TanskiSzymon/open-pocket/hardware/mechanical/drawings/lid-drawing.pdf

70.4

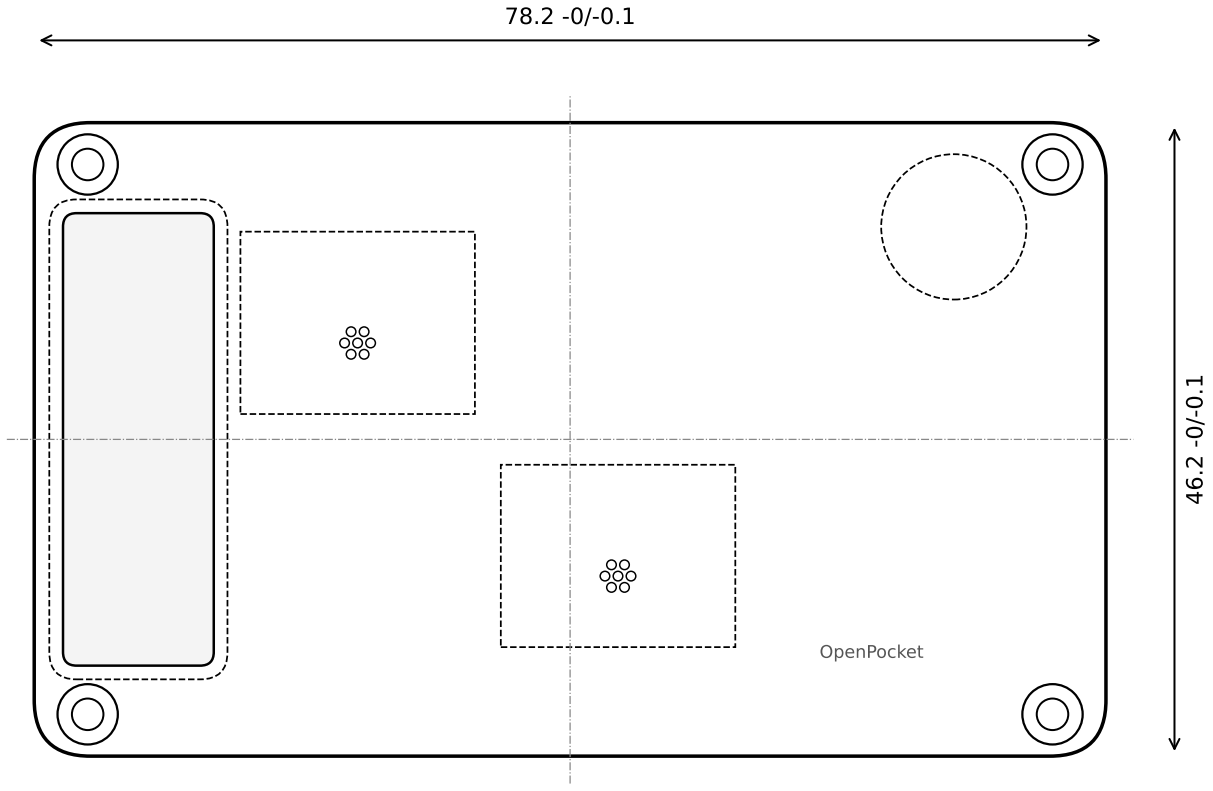
[picture p11: figure]
OpenPocket

40.1

RF window 11.0 x 33.0 R1.0 THRU at (-31.5, 0.0); underside recess 13.0 x 35.0 R2.0 ↓1.0

Mic recess 1 (underside) 17.1 x 13.3 ↓0.5 at (-15.5, 8.5); 7x Ø0.7 THRU grille (centre + hexagon, pitch 0.95) at (-15.51, 7.03)

Mic recess 2 (underside) same, at (3.5, -8.5); grille at (3.49, -9.97)

No LED hole: the status LED sits under the RF window insert, which is translucent

Motor recess (underside) Ø10.6 ↓0.5 at (28.0, 15.5)

4x Ø2.3 THRU, 90° countersink Ø4.4 on the top face, mouth R0.3, at (±35.2, ±20.1)

TOP VIEW (outside face), scale 1:1 at A3. Underside features shown dashed.

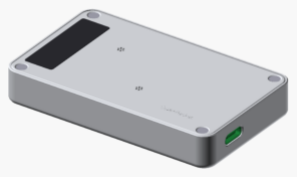
[picture p12: figure]

2.0

Plate 2.0 ±0.05, flatness 0.1. Recesses from the underside: RF flange ↓1.0, mics ↓0.5, motor ↓0.5 (all ±0.05). Top outer edge R0.5 round.

### SECTION B-B (along X through the RF window and a mic recess), scale 2:1

Isometric reference (not to scale)

# OpenPocket v0 — LID

Part no. OP0-MECH-011 | Rev B | Sheet 1/1 | RFQ ref. OP0-RFQ-001

MATERIAL: Aluminium 6061-T6 plate.

OVERALL: 78.2 x 46.2 x 2.0 mm, corners R4.1. Outline -0/-0.1:

the lid drops into the shell rebate (78.4 x 46.4) with 0.1 per side.

THICKNESS: 2.0 ±0.05, flatness 0.1 (the lid sits flush with the shell top).

SCREW HOLES: 4x Ø2.3 THRU with 90° countersink Ø4.4 on the top face,

mouth rounded R0.3 (no sharp ring). M2 flat heads seat 0.3 below the face.

Position ±0.05 (match the shell bosses).

RF WINDOW: 11.0 x 33.0 THRU, corners R1.0; underside recess

13.0 x 35.0 R2.0 ↓1.0 for the window insert flange.

UNDERSIDE RECESSES: 2x mic 17.1 x 13.3 ↓0.5;

motor Ø10.6 ↓0.5. Corner R0.5 max. Depth ±0.05.

MIC GRILLES: 2x 7 holes Ø0.7 THRU (acoustic), pitch 0.95.

Deburr both sides, no chamfer.

MARKING: laser mark on the top face (STEP, ↓0.05), after anodizing.

EDGES: R0.5 round on the top outer edge, R0.3 on the countersink mouths;

break the rest 0.2 max.

SURFACE: Ra 1.6 µm or better on the top face (visible product).

FINISH: same as the shell, same batch: (a) bead blast + black anodize Type II;

(b) bead blast + clear anodize; (c) as machined. Quote each.

QUANTITY FOR QUOTE: 1 / 10 / 100 / 1000 pcs, together with OP0-MECH-003 (shell).

FILES: openpocket-lid.step (master) + this PDF. STEP governs if in conflict.

ALL DIMENSIONS IN MILLIMETRES. Third-angle projection.

OpenPocket, open-source hardware (CERN-OHL-P v2). Contact on the cover sheet. Date: 2026-10-19. STEP file governs; this sheet carries tolerances, threads and finish.
