TanskiSzymon/open-pocket/hardware/mechanical/drawings/shell-drawing.pdf

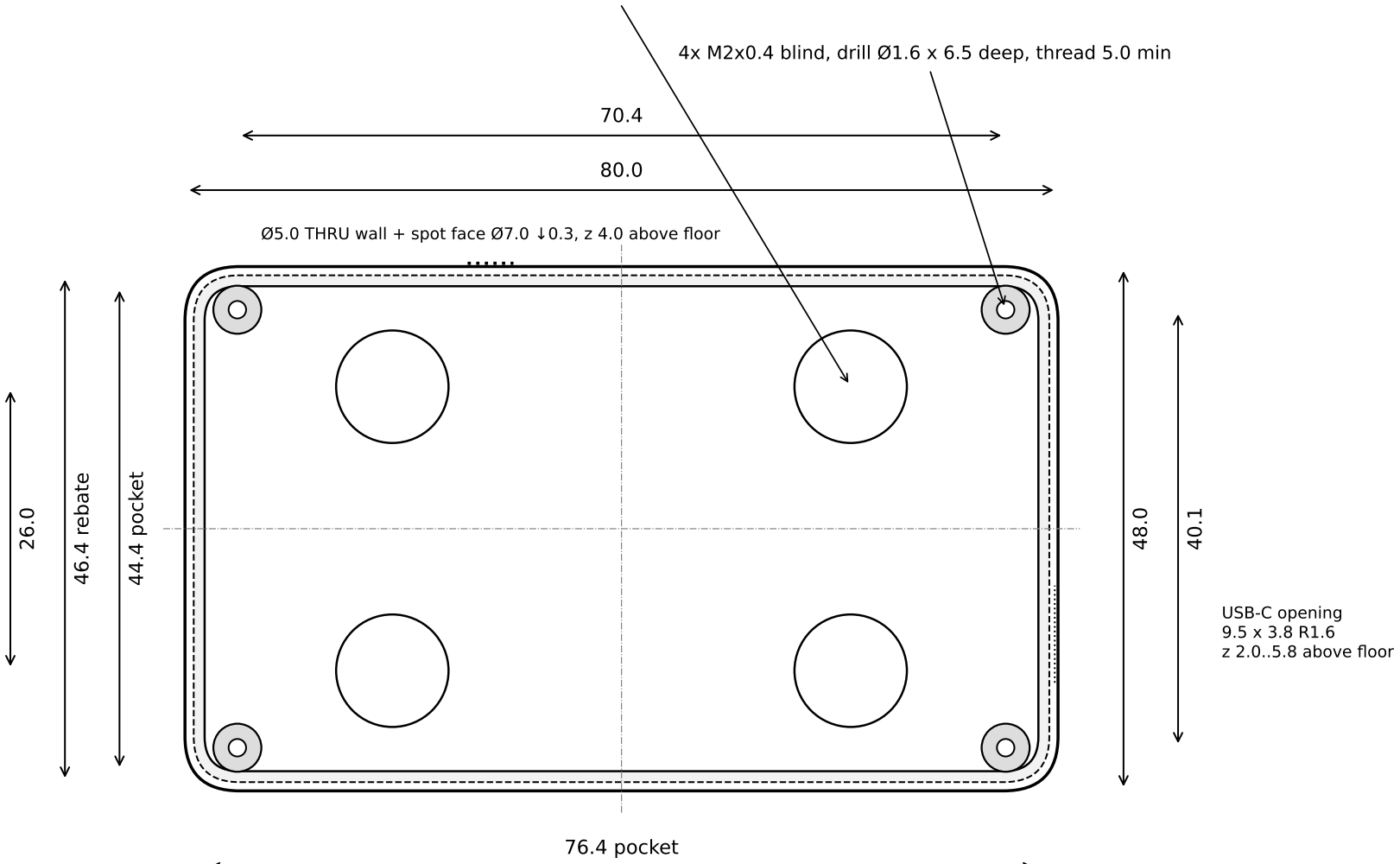
[picture p13: figure]
USB-C opening 9.5 x 3.8 R1.6 z 2.0..5.8 above floor; 76.4 pocket; 46.4 rebate; 44.4 pocket

Ø5.0 THRU wall + spot face Ø7.0 ↓0.3, z 4.0 above floor

78.4 rebate

42.0

4x M2x0.4 blind, drill Ø1.6 x 6.5 deep, thread 5.0 min

4x Ø10.3 +0.1/-0 POCKET ↓2.1 in the floor

R5 x4 outside, R3.2 x4 pocket (Ø6 end mill), R4.2 rebate

### TOP VIEW (open side), scale 1:1 at A3

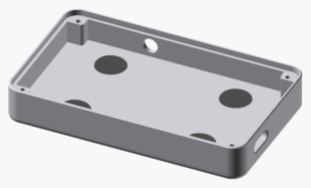
[picture p14: figure]

80.0

12.6

7.6 pocket depth

2.0 rebate

3.0

floor

Walls 1.8 (rebate leaves 0.8 outside the lid). Pocket floor to rebate 7.6 ±0.05.
Magnet pockets ↓2.1 leave 0.9 floor. R2.0 round on the bottom outer edge, C0.3 bright-cut chamfer on the top outer edge.

### SECTION A-A (along X through a boss row and the magnet pockets), scale 2:1

Isometric reference (not to scale)

# OpenPocket v0 — SHELL (floor + walls)

Part no. OP0-MECH-003 | Rev B | Sheet 1/1 | RFQ ref. OP0-RFQ-001

MATERIAL: Aluminium 6061-T6, from solid.

OVERALL: 80.0 x 48.0 x 12.6 mm, outer corners R5.

POCKET: 76.4 x 44.4 ±0.05, depth 7.6 ±0.05 from the rebate floor,

corner R3.2; 4 corner bosses Ø4.4 blended into the walls, flat inner face at |Y| = 18.5.

REBATE: 78.4 x 46.4 +0.05/-0, depth 2.0 +0/-0.05 from the top face,

corner R4.2. The lid (OP0-MECH-011) sits flush in it.

THREADS: 4x M2x0.4 blind in the bosses, drill Ø1.6 x 6.5, thread 5.0 min,

from the top. Do NOT break through the floor. Mask for anodize or chase after.

MAGNET POCKETS: 4x Ø10.3 +0.1/-0, depth 2.1 ±0.05 from the pocket floor,

flat bottom, floor left 0.9. Position ±0.05.

OPENINGS: USB-C 9.5 x 3.8 R1.6 ends, C0.3 x 45° outside, through the +X wall;

Ø5.0 through the +Y wall with a spot face Ø7.0 ↓0.3. Positions per STEP, ±0.1.

TOLERANCES (unless noted): ±0.1 linear; bottom flatness 0.1; walls 1.8 ±0.1.

EDGES: R2.0 round bottom outer edge; C0.3 x 45° top outer edge, cut after

anodizing (bright edge) if you offer it, else before. Break the rest 0.2 max.

MARKING: laser mark on the bottom face (text in STEP, ↓0.05), after anodizing.

SURFACE: Ra 1.6 µm or better on all outside faces (visible product).

FINISH: (a) bead blast + black anodize Type II; (b) bead blast + clear

anodize; (c) as machined. Quote each. Mask the threads.

QUANTITY FOR QUOTE: 1 / 10 / 100 / 1000 pcs, together with OP0-MECH-011 (lid).

1 pc now for testing, ~1000 target. State lead time, capacity, shipping PL / USA.

FILES: openpocket-shell.step (master) + this PDF. STEP governs if in conflict.

ALL DIMENSIONS IN MILLIMETRES. Third-angle projection.

OpenPocket, open-source hardware (CERN-OHL-P v2). Contact on the cover sheet. Date: 2026-10-19. STEP file governs; this sheet carries tolerances, threads and finish.
