TanskiSzymon/open-pocket/hardware/mechanical/renders/render-exploded.png

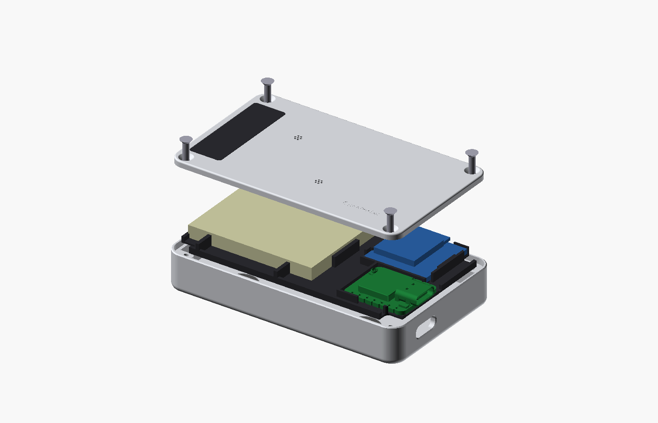
hardware/mechanical/renders/render-exploded.png
