TanskiSzymon/open-pocket/hardware/mechanical/renders/render-lid-under.png

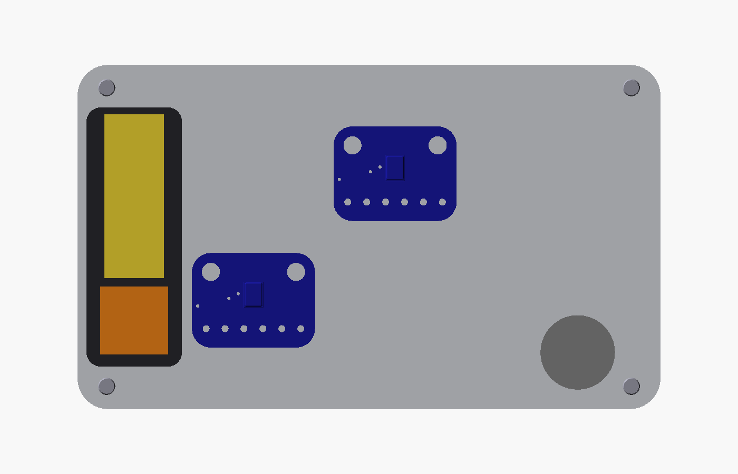
hardware/mechanical/renders/render-lid-under.png
