TanskiSzymon/open-pocket/hardware/mechanical/renders/render-shell.png

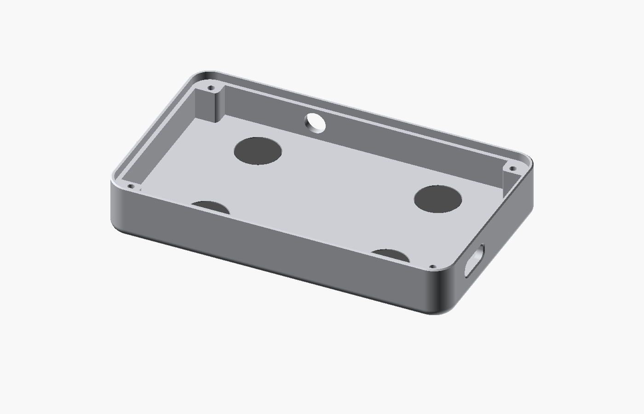
hardware/mechanical/renders/render-shell.png
