TanskiSzymon/open-pocket/hardware/mechanical/renders/render-top.png

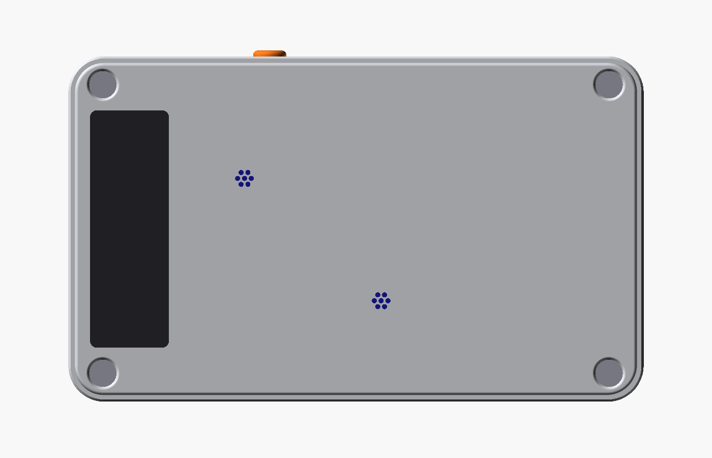
hardware/mechanical/renders/render-top.png
