TanskiSzymon/open-pocket/hardware/mechanical/renders/render-tray.png

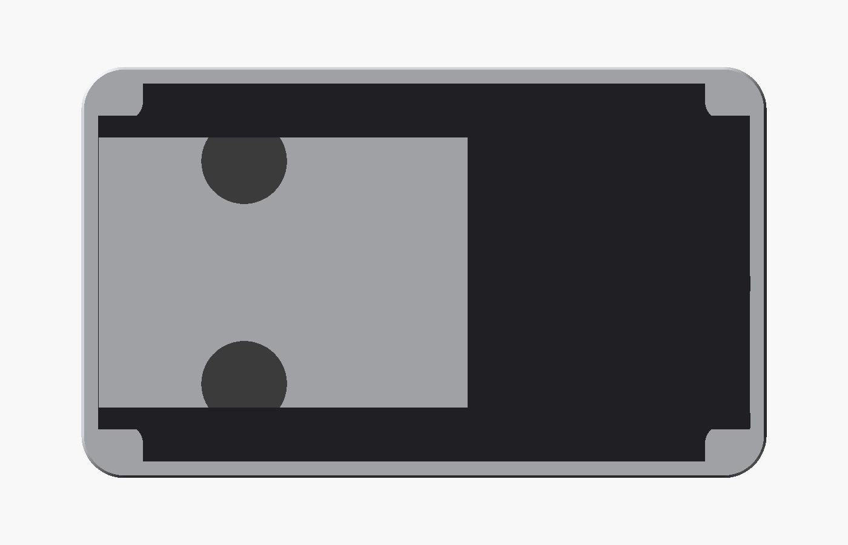
hardware/mechanical/renders/render-tray.png
