TanskiSzymon/open-pocket/hardware/mechanical/renders/render-usb-end.png

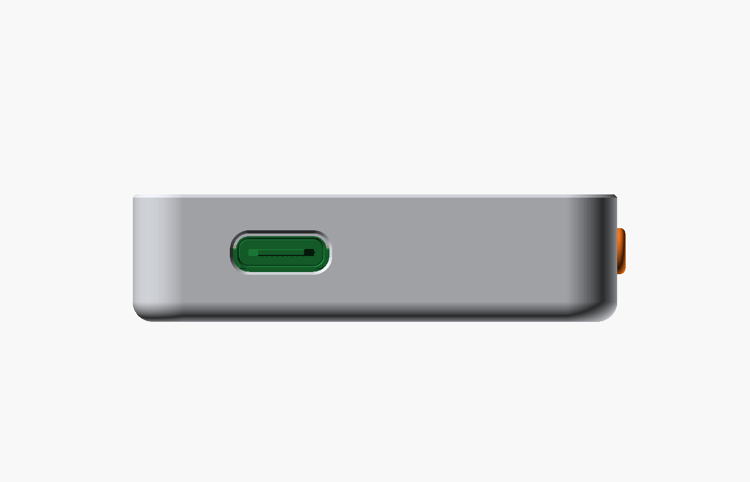
hardware/mechanical/renders/render-usb-end.png
