TanskiSzymon/open-pocket/images/openpocket-collage.jpg

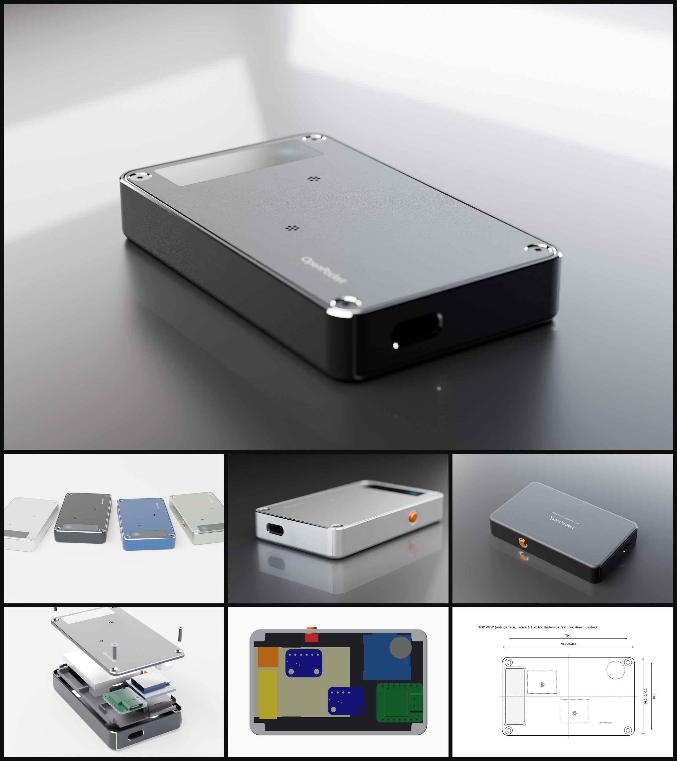
images/openpocket-collage.jpg
