TanskiSzymon/open-pocket/bom/bom.csv

id | category | qty | description | mpn_or_part | manufacturer | preferred_supplier | supplier_sku_or_link | alt_supplier | unit_price_usd_est | required | file | notes
OP0-ELEC-001 | electronics | 1 | Seeed Studio XIAO ESP32S3 (plain, no Sense expansion board; MCU + Wi-Fi/BLE + LiPo charger, FPC antenna included) | 113991114 | Seeed Studio | Digi-Key | 1597-113991114-ND ($7.49, 10113 in stock 13.10.2026) | Seeed Studio https://www.seeedstudio.com/XIAO-ESP32S3-p-5627.html ($7.49) | 7.49 | yes |  | The Sense expansion board (camera + microSD) stacks to 8.5 mm; the plain board is 4.5 mm and sets the slim enclosure. microSD comes from OP0-ELEC-014.
OP0-ELEC-002 | electronics | 2 | I2S MEMS microphone breakout SPH0645LM4H (bottom port) | 3421 | Adafruit | Digi-Key | 1528-1908-ND ($6.95, 2163 in stock 13.10.2026) | Adafruit https://www.adafruit.com/product/3421 (in stock) | 6.95 | yes |  | ICS-43434 (6049) is discontinued; 3421 is the drop-in. Verify port position against the 7-hole Ø0.7 lid grille.
OP0-ELEC-003 | electronics | 1 | LiPo battery 403040, 3.7 V 450-500 mAh, 4 mm thick, with protection circuit (PCM) and leads | 403040 | generic (Liter / HXJNLDC / AKZYTUE) | Amazon | https://www.amazon.com/dp/B0CHBGZ778 (403040 500 mAh, PCM) | https://www.amazon.com/dp/B09FLYNRPG (Liter 403040 500 mAh, JST) | 7.00 | yes |  | Envelope used in CAD: 42.5 x 31 x 4.2 mm incl. PCM lead end; measure before fitting. ~10 h recording at 32 kbps MP3. Connector is cut off, leads solder to the XIAO BAT pads.
OP0-ELEC-004 | electronics | 1 | Tactile switch 6x6 mm, through-hole, 5.0 mm total height, round plunger, 100 gf | B3F-1022 | Omron (Aratas) | Digi-Key | search "B3F-1022" (verify stock before ordering) | any 6x6 THT tact switch with 5.0 mm total height and Ø3.5 round plunger | 0.40 | yes |  | Since 19.10.2026 the 5.0 mm version: the body sits 0.8 mm behind the wall and the plunger drives the captive aluminium button cap (OP0-MECH-012).
OP0-ELEC-005 | electronics | 1 | NeoPixel Mini Button PCB (WS2812B/SK6812, 9.1 x 9.1 x 3.2 mm) — pack of 5 | 1612 | Adafruit | Mouser | 485-1612 ($4.95, 15 in stock 19.10.2026) | Adafruit https://www.adafruit.com/product/1612 ($4.95) | 4.95 | yes |  | Only one used. Sits in a 0.4 mm recess on the underside of the translucent RF window insert at (-31.5, 11.2); no hole in the metal lid. Digi-Key 1528-1104-ND is Adafruit 1655 (bare 5050 LEDs), not this part. Rated 5 V (3.5 V min): at 3.3 V colours are dimmer; check on unit 1. Flora NeoPixel 1260 was the first choice but is out of stock at Adafruit (13.10.2026).
OP0-ELEC-006 | electronics | 1 | Vibration motor, coin 10 mm x 2.7 mm, 3 V | 1201 | Adafruit | Adafruit | https://www.adafruit.com/product/1201 | Digi-Key 1528-1177-ND | 1.95 | optional |  | Haptic feedback like the original Pocket. Needs driver below.
OP0-ELEC-007 | electronics | 1 | NPN transistor 2N2222 TO-92 | PN2222A | onsemi | Digi-Key | search "PN2222A" (onsemi PN2222ABU) or P2N2222A | Adafruit 756 (PN2222, pack of 10) | 0.20 | optional |  | Motor driver.
OP0-ELEC-008 | electronics | 1 | Diode 1N4148 (flyback across motor) | 1N4148 | onsemi | Digi-Key | 1N4148FS-ND ($0.10, in stock) |  | 0.10 | optional
OP0-ELEC-009 | electronics | 1 | Resistor 470 Ω 1/4 W (motor base) | CF14JT470R | Stackpole | Digi-Key | CF14JT470RCT-ND ($0.10) |  | 0.10 | optional |  | Was 1 kΩ until 19.10.2026: 470 Ω gives ~5.5 mA base current for hard saturation at the motor start current.
OP0-ELEC-010 | electronics | 2 | Resistor 220 kΩ 1/4 W (VBAT divider) | CF14JT220K | Stackpole | Digi-Key | CF14JT220KCT-ND ($0.10) |  | 0.10 | optional |  | Battery voltage sense on D0.
OP0-ELEC-011 | electronics | 3 | Capacitor 100 nF ceramic X7R (microSD breakout VCC/GND, VBAT divider D0 to GND, across motor) | K104K15X7RF5TL2 | Vishay | Digi-Key | BC1084CT-ND ($0.31) |  | 0.31 | yes |  | 2 required: at the microSD breakout (VCC to GND) and D0 to GND on the VBAT divider. The third, across the motor terminals, is optional with the motor.
OP0-ELEC-012 | electronics | 1 | microSD card 32 GB, class 10 / A1 |  | SanDisk | Amazon | https://www.amazon.com/s?k=SanDisk+Ultra+32GB+microSDHC+A1 |  | 8.00 | yes |  | Recordings are stored here.
OP0-ELEC-013 | electronics | 1 | Silicone hook-up wire 30 AWG, 6 colours (spool kit) |  |  | Amazon | https://www.amazon.com/dp/B07G2SWB19 (TUOFENG 30 AWG, 6 colours, 20 m each) | Adafruit 2051 (wire bundle) | 9.00 | yes |  | About 60 cm used per device.
OP0-ELEC-014 | electronics | 1 | microSD breakout, SparkFun microSD Transflash Breakout (Molex push-push socket, 21.6 x 20.3 x 3.5 mm) | BOB-00544 | SparkFun | SparkFun | https://www.sparkfun.com/sparkfun-microsd-transflash-breakout.html ($5.95, in stock 13.10.2026) | Digi-Key 1568-1345-ND (search "BOB-00544") | 5.95 | yes |  | Wired over SPI: CS D5, SCK D8, DO D9, DI D10, 3V, GND. Card edge toward the +Y wall slot; snap lips on the tub hold the PCB. Do not solder the header.
OP0-ELEC-015 | electronics | 4 | Resistor 10 kΩ 1/4 W (microSD pull-ups) | CF14JT10K0 | Stackpole | Digi-Key | CF14JT10K0CT-ND ($0.10) |  | 0.10 | yes |  | Pull-ups to 3V3 at the breakout pads on CS, DO (MISO), DAT1 (socket pin 8) and DAT2 (socket pin 1). Holds the card deselected while the ESP32 boots.
OP0-ELEC-016 | electronics | 1 | Resistor 10 kΩ 1/4 W (motor base-emitter pull-down) | CF14JT10K0 | Stackpole | Digi-Key | CF14JT10K0CT-ND ($0.10) |  | 0.10 | optional |  | Keeps Q1 off while GPIO44 floats during boot. Same part as OP0-ELEC-015 (order 5).
OP0-ELEC-017 | electronics | 1 | Resistor 100 kΩ 1/4 W (I2S DOUT pull-down) | CF14JT100K | Stackpole | Digi-Key | CF14JT100KCT-ND ($0.10) |  | 0.10 | yes |  | DOUT to GND at the XIAO pin (D3): discharges the shared data line while both mics are high-Z (SPH0645 datasheet).
OP0-ELEC-018 | electronics | 1 | Resistor 33 Ω 1/4 W (I2S BCLK series) | CF14JT33R0 | Stackpole | Digi-Key | CF14JT33R0CT-ND ($0.10) |  | 0.10 | yes |  | In series with BCLK right at the XIAO pin (D1): one wire drives two mics.
OP0-ELEC-019 | electronics | 1 | Capacitor 10 µF 16 V X5R 0805 (microSD breakout) | GRM21BR61C106KE15L | Murata | JLCPCB / LCSC | C77075 ($0.04) | Digi-Key 490-3886-1-ND (out of stock 19.10.2026) | 0.04 | yes |  | Across VCC/GND at the breakout pads, beside the 100 nF (card write bursts). 0805 solders across two adjacent pads or wire ends.
OP0-ELEC-020 | electronics | 1 | Capacitor 10 µF 16 V X5R 0805 (motor bulk) | GRM21BR61C106KE15L | Murata | JLCPCB / LCSC | C77075 ($0.04) | Digi-Key 490-3886-1-ND (out of stock 19.10.2026) | 0.04 | optional |  | Motor+ (BAT+) to GND at the motor. Same part as OP0-ELEC-019 (order 2).
OP0-MECH-001 | 3d-print | 1 | Tray (printed): floor plate with the XIAO and microSD cradles, snap lips, battery cutout and ribs, switch cradle; drops into the shell pocket | OP0-MECH-001 | OpenPocket | self-print / MakerWorld | hardware/mechanical/export/openpocket-tray.stl | JLC3DP / Craftcloud | 1.00 | yes | hardware/mechanical/export/openpocket-tray.stl | PETG or PLA, 0.2 mm layers, print flat (floor on the bed), no supports. Check the 0.5 / 0.3 mm snap lips on the first print.
OP0-MECH-002 | 3d-print | 1 | RF window insert (printed, translucent smoke or natural PETG; or laser-cut smoked acrylic): 10.8 x 32.8 x 2.0 plug (R0.9 corners) with a 1 mm flange, glued flush into the lid cutout; antenna and NeoPixel under it | OP0-MECH-002 | OpenPocket | self-print / MakerWorld | hardware/mechanical/export/openpocket-rf-insert.stl | JLC3DP / Craftcloud | 0.20 | yes | hardware/mechanical/export/openpocket-rf-insert.stl | Print flange down, 0.1 mm layers, 100% infill so it stays translucent. Alternative: laser-cut 2 mm smoked acrylic plug + 1 mm flange glued. The FPC antenna sticks to its underside; the NeoPixel sits in a 0.4 mm recess at the +Y end and lights the whole window.
OP0-MECH-003 | cnc-aluminium | 1 | Shell, aluminium 6061-T6 from solid, 80 x 48 x 12.6 mm: floor 3 mm with 4 magnet pockets, 1.8 mm walls, pocket 76.4 x 44.4 x 7.6, lid rebate, 4 corner bosses tapped M2 blind, USB-C opening 9.5 x 3.8 and button hole; bead blast + anodize | OP0-MECH-003 | OpenPocket | CNC shop (STEP + drawing) | hardware/mechanical/drawings/ | Xometry / Protolabs / Fictiv | 150.00 | yes | openpocket-backplate.step | Price is the thing we are measuring. Drawing: hardware/mechanical/drawings/shell-drawing.pdf
OP0-MECH-011 | cnc-aluminium | 1 | Lid, aluminium 6061-T6 plate, 78.2 x 46.2 x 2.0 mm: 4 countersunk M2 holes, 2 seven-hole mic grilles (Ø0.7), 11 x 33 R1 RF window cutout, laser mark, underside recesses for mics / motor / window flange; bead blast + anodize | OP0-MECH-011 | OpenPocket | CNC shop (STEP + drawing) | hardware/mechanical/drawings/ | same shop as the shell, same anodize batch | 60.00 | yes | hardware/mechanical/export/openpocket-lid.step | Two-sided machining (top: countersinks, window; bottom: recesses). Drawing: hardware/mechanical/drawings/lid-drawing.pdf
OP0-MECH-012 | cnc-aluminium | 1 | Button cap, turned aluminium 6061, Ø4.6 shaft with Ø6.2 x 0.35 flange (captive inside the wall), domed face 0.8 mm proud; orange anodize | OP0-MECH-012 | OpenPocket | CNC / lathe shop | hardware/mechanical/export/openpocket-button-cap.step | print in PETG until machined | 3.00 | yes | hardware/mechanical/export/openpocket-button-cap.step | Fits over the B3F-1022 plunger (bore Ø3.6). Insert from inside before the switch.
OP0-MECH-004 | hardware | 4 | Neodymium disc magnet N52, 10 mm x 2 mm |  |  | Amazon | https://www.amazon.com/dp/B0C5V31YCR (10x2 mm, 20 pcs; check grade) or search "AplysiaTech 10x2mm N52" | K&J Magnetics D62 (3/8 x 1/8 in = 9.5 x 3.2 mm, needs pocket depth 3.4) | 0.25 | yes |  | Glued into plate pockets with CA or epoxy. Check polarity against a MagSafe phone before gluing.
OP0-MECH-005 | hardware | 4 | Screw M2 x 8 mm flat head countersunk (90 deg), Phillips or Torx, stainless 18-8 (A2) |  |  | Amazon | https://www.amazon.com/s?k=M2+x+8mm+flat+head+countersunk+screws+stainless (100 pcs) | McMaster-Carr: metric 18-8 flat head Phillips, M2 x 0.4, 8 mm | 0.15 | yes |  | Through the lid countersinks into the blind M2 threads in the shell bosses (5 mm engagement). Tighten lightly; aluminium threads.
OP0-MECH-006 | consumable | 1 | Double-sided tape 0.2 mm (3M 9448A or similar), 10 mm wide | 9448A | 3M | Amazon | https://www.amazon.com/s?k=3M+9448A+double+sided+tape+10mm |  | 5.00 | yes |  | Mics (ring around the port = acoustic seal), LED, motor, antenna to lid.
OP0-MECH-007 | consumable | 1 | Foam tape 0.5 mm double-sided (battery pad) |  |  | Amazon | https://www.amazon.com/s?k=0.5mm+double+sided+foam+tape |  | 4.00 | yes |  | Under the battery on the aluminium plate.
OP0-MECH-008 | consumable | 1 | Kapton tape 10 mm |  |  | Amazon | https://www.amazon.com/s?k=kapton+tape+10mm |  | 5.00 | yes |  | Over XIAO battery pads and switch legs.
OP0-MECH-009 | consumable | 1 | Heat-shrink tubing 1.5 mm and 3 mm |  |  | Amazon | https://www.amazon.com/s?k=heat+shrink+tubing+kit+1.5mm+3mm |  | 6.00 | yes
OP0-MECH-010 | consumable | 1 | CA glue (magnets) |  |  | Amazon | https://www.amazon.com/s?k=Loctite+401 |  | 4.00 | yes
