TanskiSzymon/open-pocket/hardware/mechanical/export/openpocket-lid-outline.dxf

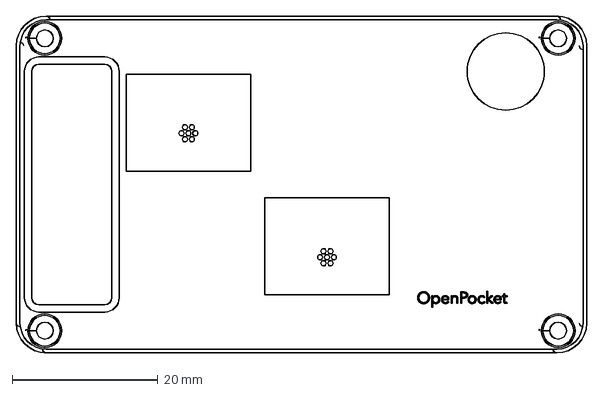
[picture p22: CAD file, 2026-10-19]
hardware/mechanical/export/openpocket-lid-outline.dxf
78.2 x 46.2 mm
