TanskiSzymon/open-pocket/hardware/mechanical/export/openpocket-shell-outline.dxf

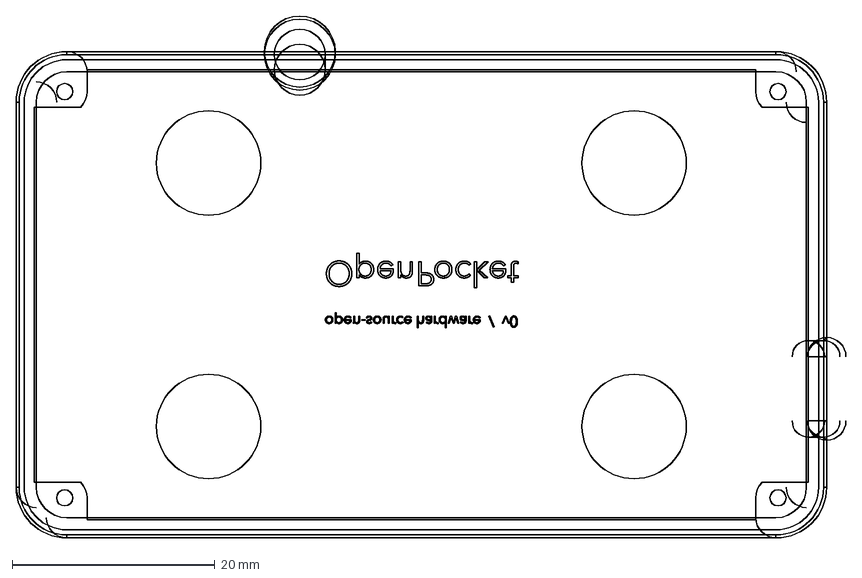
[picture p23: CAD file, 2026-10-19]
hardware/mechanical/export/openpocket-shell-outline.dxf
81.9 x 51.5 mm
