TanskiSzymon/open-pocket/hardware/mechanical/export/comp-mic2.stl

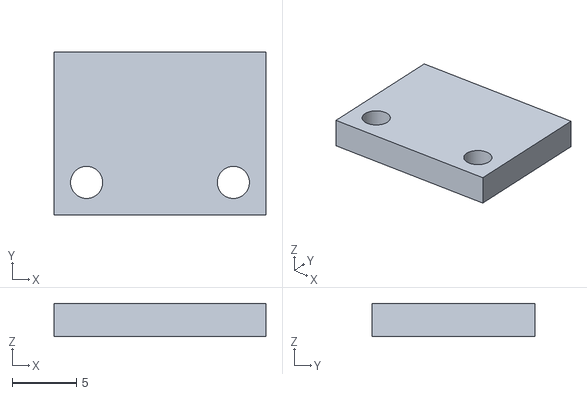
[picture p24: CAD file, 2026-10-19]
hardware/mechanical/export/comp-mic2.stl
16.5 x 12.7 x 2.60
