TanskiSzymon/open-pocket/hardware/mechanical/export/comp-sd.stl

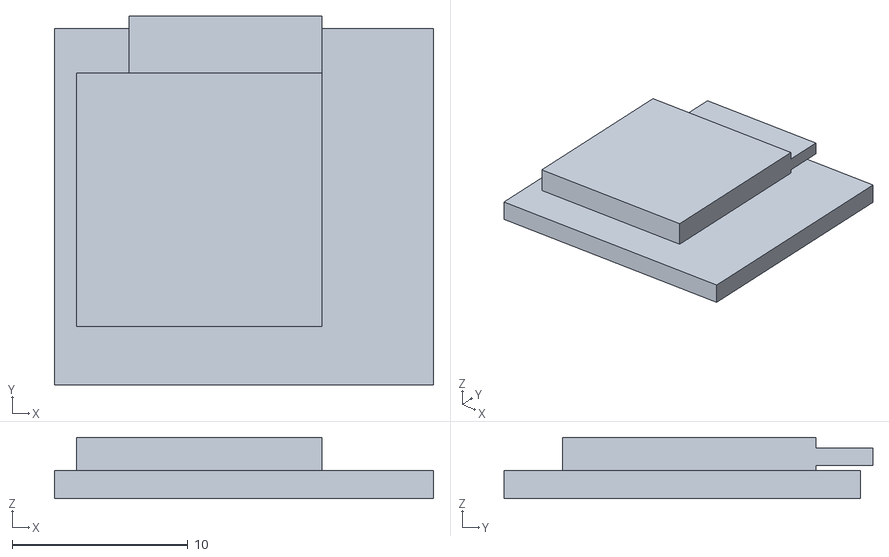
[picture p25: CAD file, 2026-10-19]
hardware/mechanical/export/comp-sd.stl
21.6 x 21.0 x 3.50
