TanskiSzymon/open-pocket/hardware/mechanical/export/openpocket-tray.step

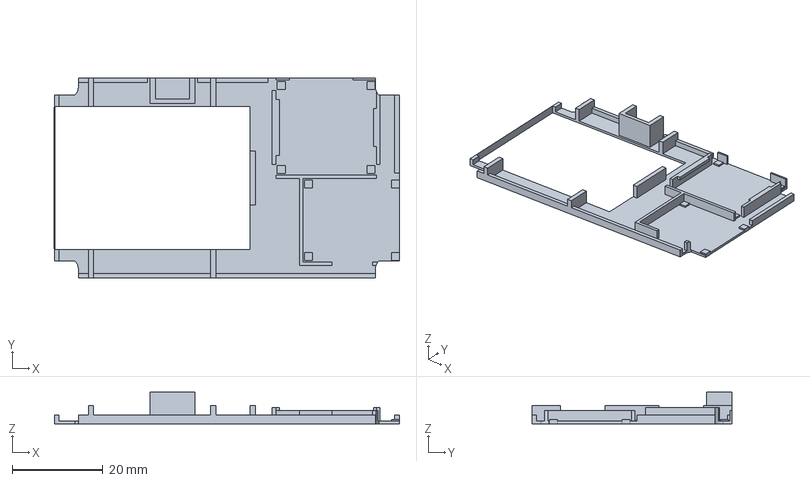
[picture p26: CAD file, 2026-10-19]
hardware/mechanical/export/openpocket-tray.step
76.2 x 44.1 x 7.00 mm
