TanskiSzymon/open-pocket/hardware/mechanical/export/openpocket-lid.step

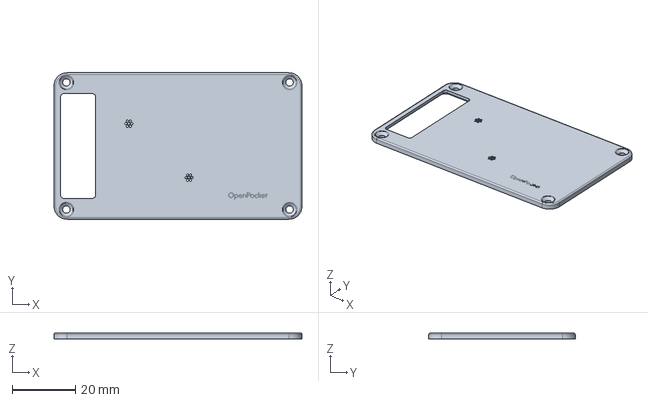
[picture p27: CAD file, 2026-10-19]
hardware/mechanical/export/openpocket-lid.step
78.2 x 46.2 x 2.00 mm
