TanskiSzymon/open-pocket/hardware/mechanical/export/comp-antenna.stl

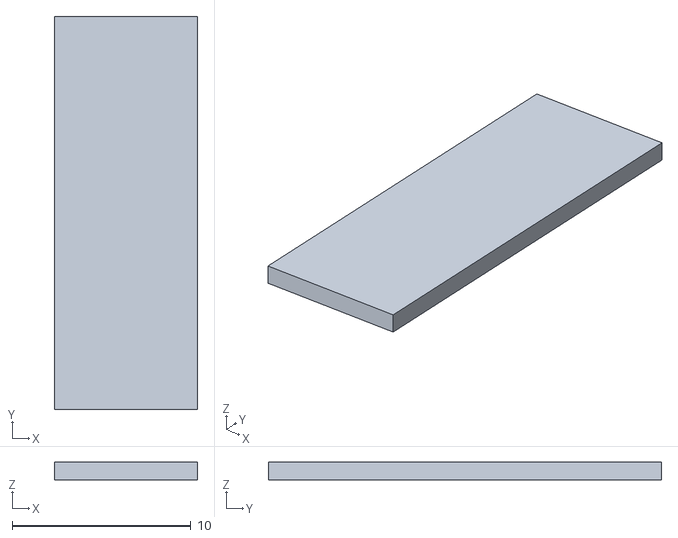
[picture p28: CAD file, 2026-10-19]
hardware/mechanical/export/comp-antenna.stl
8.00 x 22.0 x 1.00
