TanskiSzymon/open-pocket/hardware/mechanical/export/comp-switch.stl

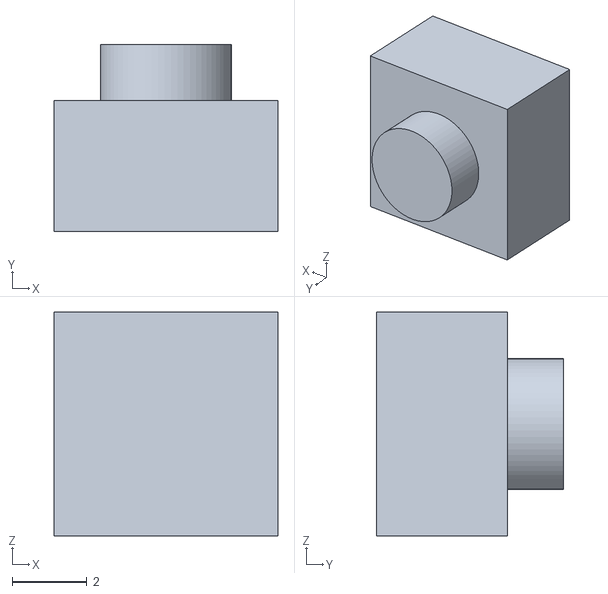
[picture p29: CAD file, 2026-10-19]
hardware/mechanical/export/comp-switch.stl
6.00 x 5.00 x 6.00
