TanskiSzymon/open-pocket/hardware/mechanical/export/comp-led.stl

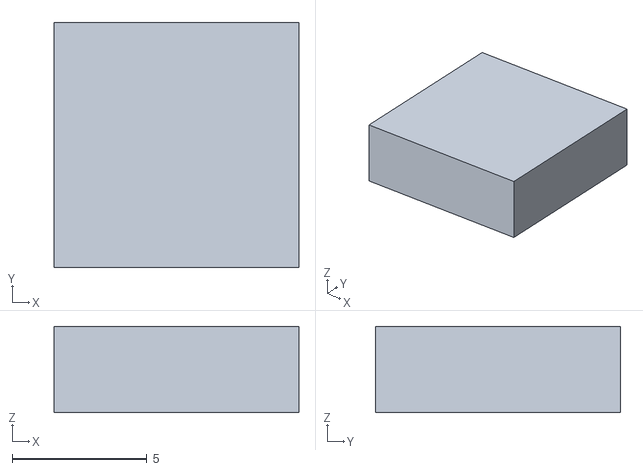
[picture p30: CAD file, 2026-10-19]
hardware/mechanical/export/comp-led.stl
9.10 x 9.10 x 3.20
