TanskiSzymon/open-pocket/hardware/mechanical/export/openpocket-shell.step

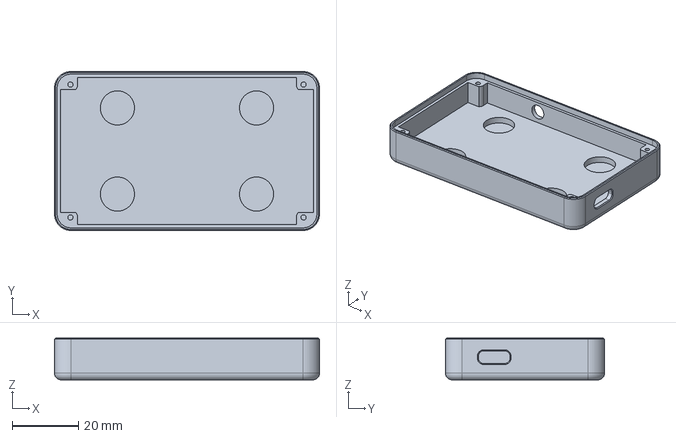
[picture p31: CAD file, 2026-10-19]
hardware/mechanical/export/openpocket-shell.step
80.0 x 48.0 x 12.6 mm
