TanskiSzymon/open-pocket/hardware/mechanical/export/comp-motor.stl

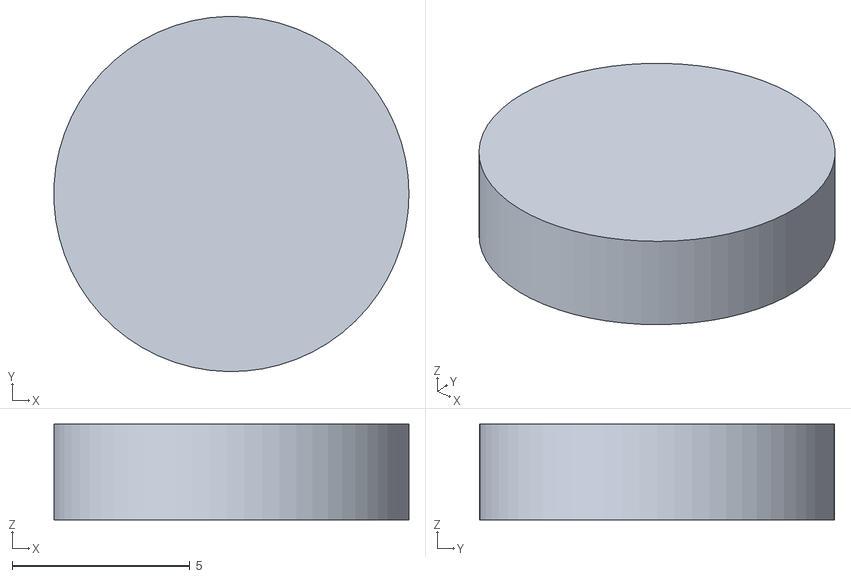
[picture p32: CAD file, 2026-10-19]
hardware/mechanical/export/comp-motor.stl
9.99 x 10.00 x 2.70
