TanskiSzymon/open-pocket/hardware/mechanical/export/comp-magnets.stl

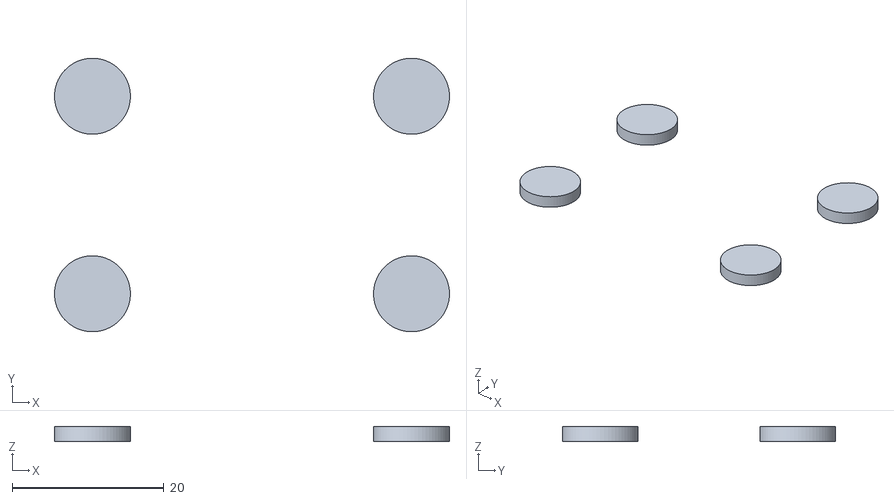
[picture p33: CAD file, 2026-10-19]
hardware/mechanical/export/comp-magnets.stl
52.0 x 36.0 x 2.00
