TanskiSzymon/open-pocket/hardware/mechanical/export/openpocket-button-cap.step

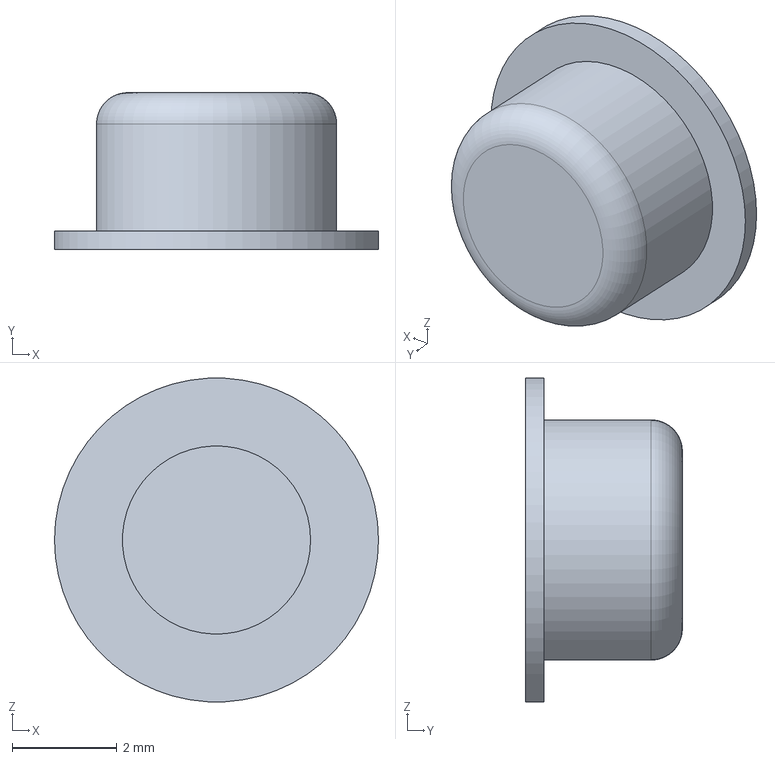
[picture p34: CAD file, 2026-10-19]
hardware/mechanical/export/openpocket-button-cap.step
6.20 x 3.00 x 6.19 mm
