TanskiSzymon/open-pocket/hardware/mechanical/export/openpocket-rf-insert.step

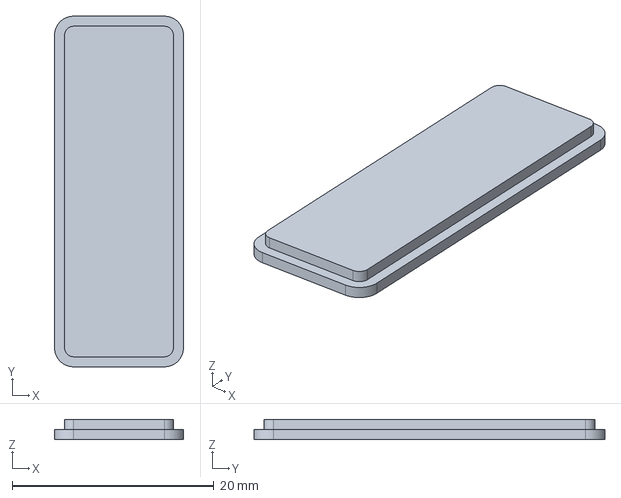
[picture p35: CAD file, 2026-10-19]
hardware/mechanical/export/openpocket-rf-insert.step
12.8 x 34.8 x 2.00 mm
