TanskiSzymon/open-pocket/hardware/mechanical/export/comp-xiao.stl

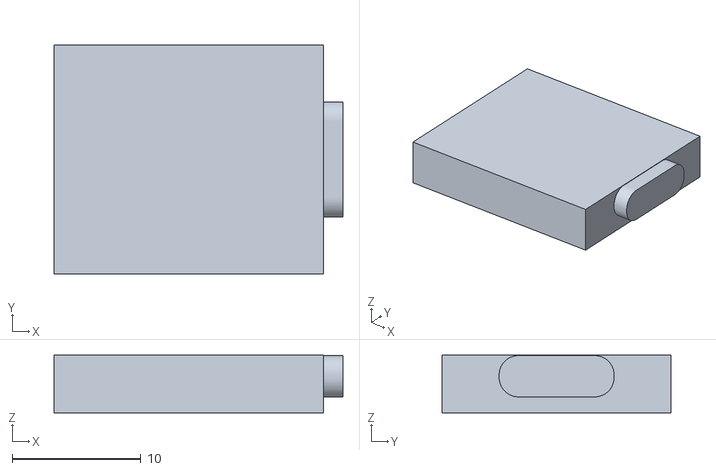
[picture p36: CAD file, 2026-10-19]
hardware/mechanical/export/comp-xiao.stl
22.5 x 17.8 x 4.50
