TanskiSzymon/open-pocket/hardware/mechanical/export/comp-battery.stl

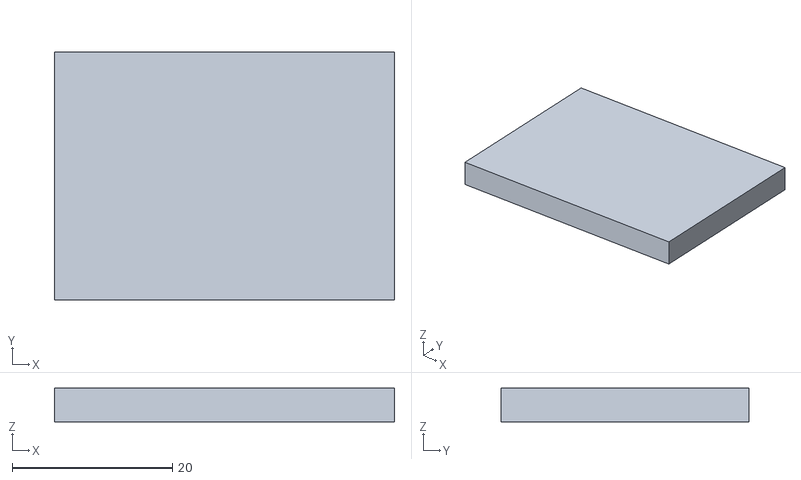
[picture p37: CAD file, 2026-10-19]
hardware/mechanical/export/comp-battery.stl
42.5 x 31.0 x 4.20
