TanskiSzymon/open-pocket/hardware/mechanical/export/comp-screws.stl

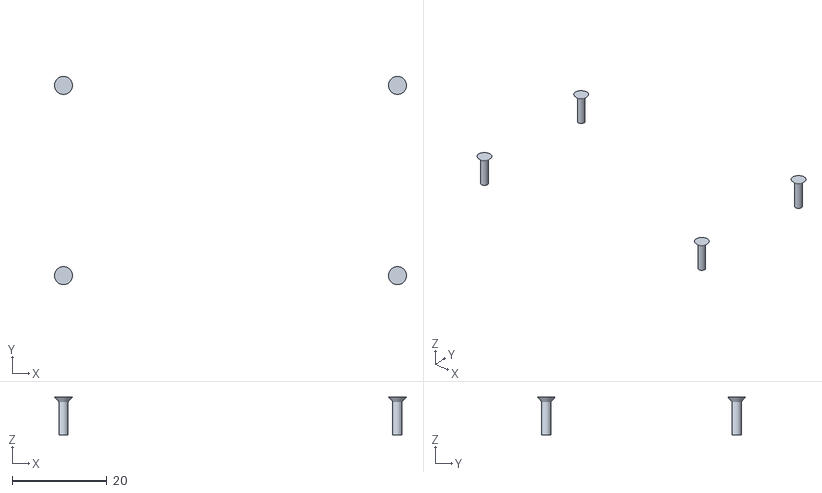
[picture p38: CAD file, 2026-10-19]
hardware/mechanical/export/comp-screws.stl
74.2 x 43.9 x 8.00
