TanskiSzymon/open-pocket/(list of files, cad)

Other CAD files:
hardware/mechanical/export/comp-mic1.stl
hardware/mechanical/export/openpocket-button-cap.stl
hardware/mechanical/export/openpocket-lid.stl
hardware/mechanical/export/openpocket-rf-insert.stl
hardware/mechanical/export/openpocket-shell.stl
hardware/mechanical/export/openpocket-tray.stl
