TanskiSzymon/open-pocket/hardware/mechanical/renders/render-assembled.png

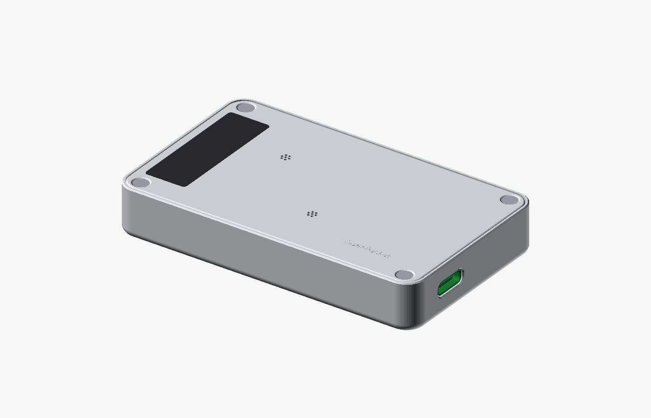
hardware/mechanical/renders/render-assembled.png
