TanskiSzymon/open-pocket/(commit log)

2026-10-19 OpenPocket v0: open-source DIY Pocket-style recorder (CAD, drawings, BOM, assembly guide, renders)
    Claude-Session: https://claude.ai/code/session_01XJw2QgFi7NR4HjsUaCb7zh
    [bom.csv, comp-antenna.stl, comp-battery.stl, comp-led.stl, comp-magnets.stl, comp-mic1.stl, comp-mic2.stl, comp-motor.stl]
2026-10-19 Electronics fixes after a red-team review
    Prompted by review comments on the first version (thanks!):
    - shared DOUT is intended I2S stereo (each SPH0645 drives DOUT only in its WS
    half); the diagram now labels the shared bus and marks junctions with dots
    - button moved to D4/GPIO5 so it can wake the ESP32-S3 from deep sleep;
    motor CTRL moved to D7/GPIO44
    - motor runs from BAT+ instead of the 3V3 rail the mics use, 470 ohm base,
    10k base-emitter pull-down, 10 uF + 100 nF at the motor; firmware only
    buzzes before capture starts and after it stops
    - 33 ohm series on BCLK, 100k DOUT pull-down; capture at 32 kHz (SPH0645
    minimum BCLK is 2.048 MHz) and downsample to 16 kHz
    - microSD pull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
    [bom.csv]
